AnttiLukats/HackaZynq/THP2015/pre-built/readme.txt

Boot files for Linux boot
use BOOT.BIN to program the SPI flash first, then copy both files to micro SD
