AnttiLukats/HackaZynq/THP2015/pre-built/Propeller/readme.txt

Parallax Propeller 1 Soft implementation, P31, P30 are on FTDI UART

P0..P15 mapped to Arduino digital pins
