AnttiLukats/HackaZynq/THP2015/hw/TE0723/manufacturing reports/PDF/SCH-TE0723-01.PDF

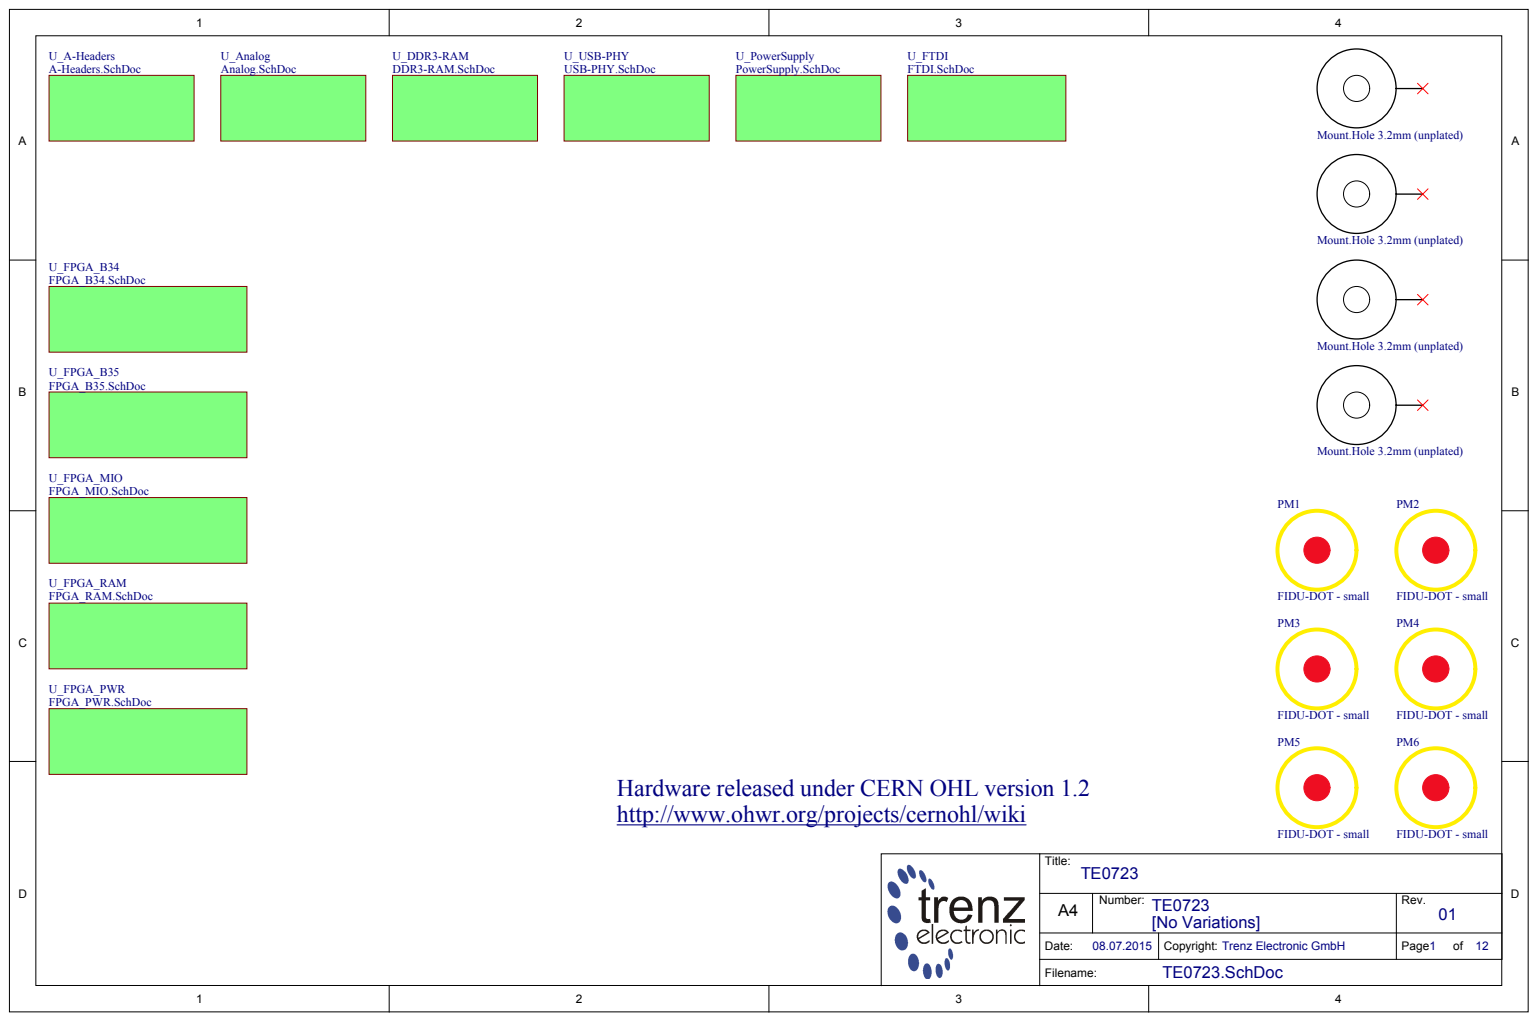
[picture p1: page 1]

Hardware released under CERN OHL version 1.2
http://www.ohwr.org/projects/cernohl/wiki

Title: TE0723

A4 | Number: TE0723 [No Variations] | Rev. 01

Date: 08.07.2015 | Copyright: Trenz Electronic GmbH | Page1 of 12

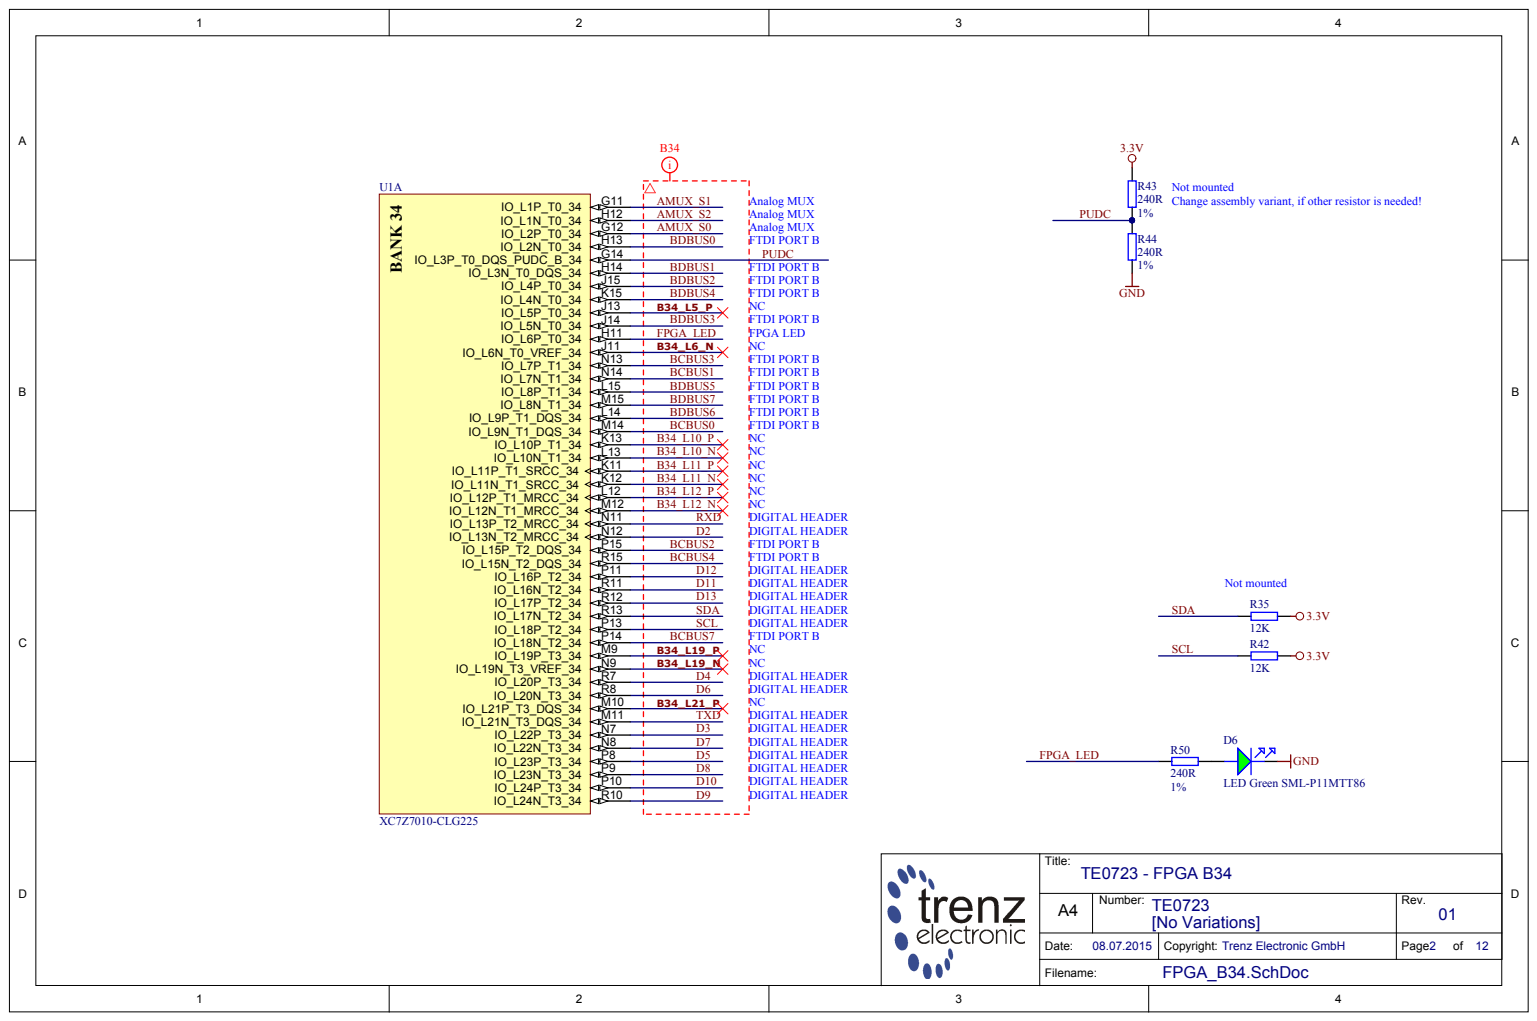
[picture p2: page 2]

Not mounted
Change assembly variant, if other resistor is needed!

Title: TE0723 - FPGA B34

A4 | Number: [No Variations] TE0723 | Rev. 01

Date: 08.07.2015 | Copyright: Trenz Electronic GmbH | Page 2 of 12

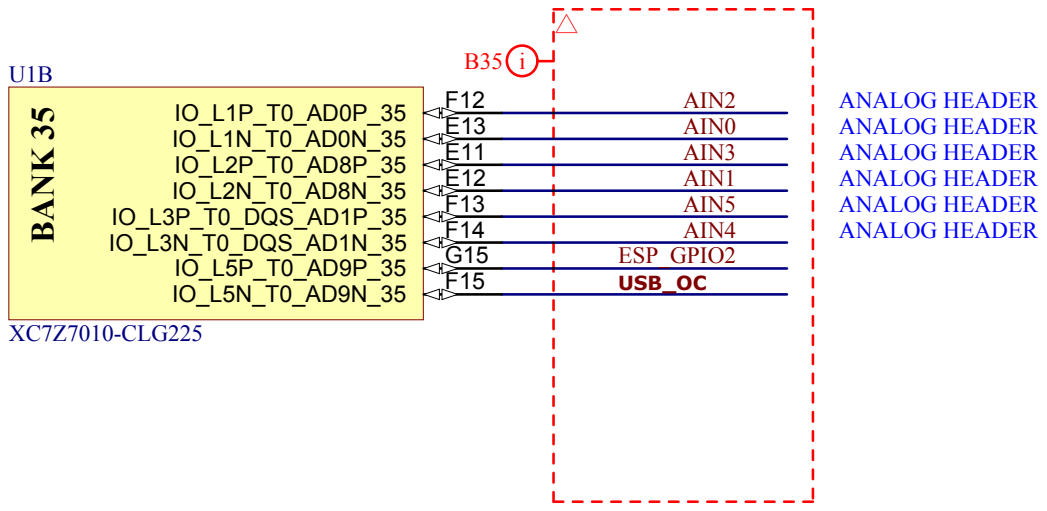
[picture p3: page 3]

Title: TE0723 - FPGA B35

A4 | Number: [No Variations] TE0723 | Rev. 01

Date: 08.07.2015 | Copyright: Trenz Electronic GmbH | Page 3 of 12

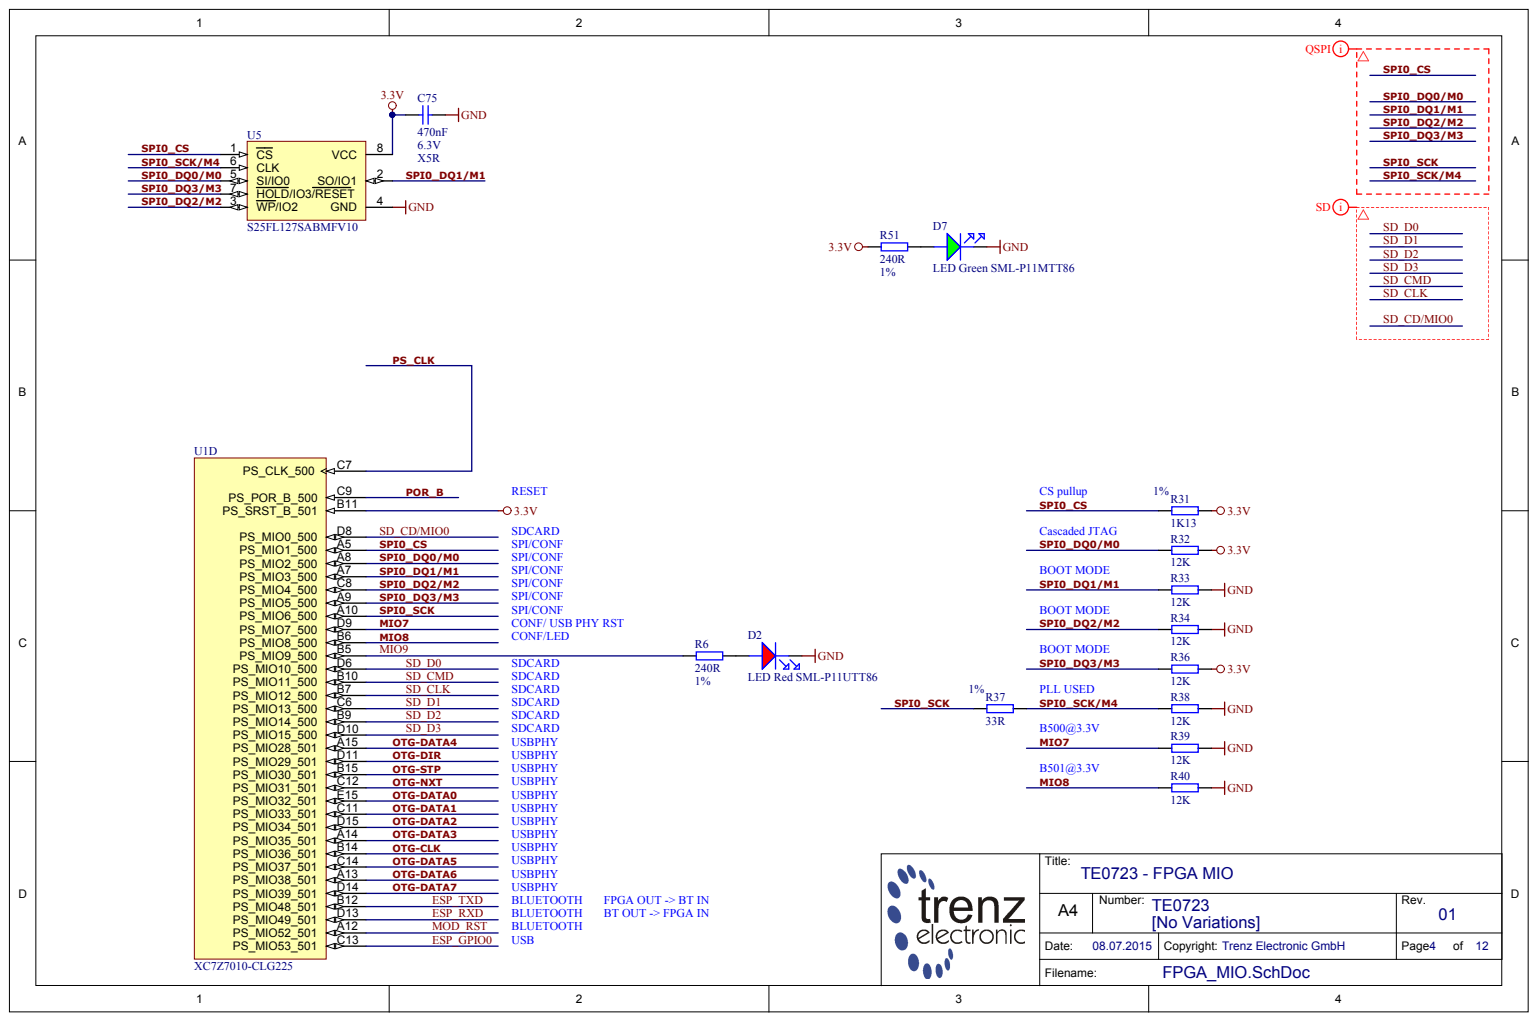
[picture p4: page 4]

Title: TE0723 - FPGA MIO

FPGA OUT -> BT IN
BT OUT -> FPGA IN

A4 | Number: TE0723 [No Variations] | Rev. 01

Date: 08.07.2015 | Copyright: Trenz Electronic GmbH | Page4 of 12

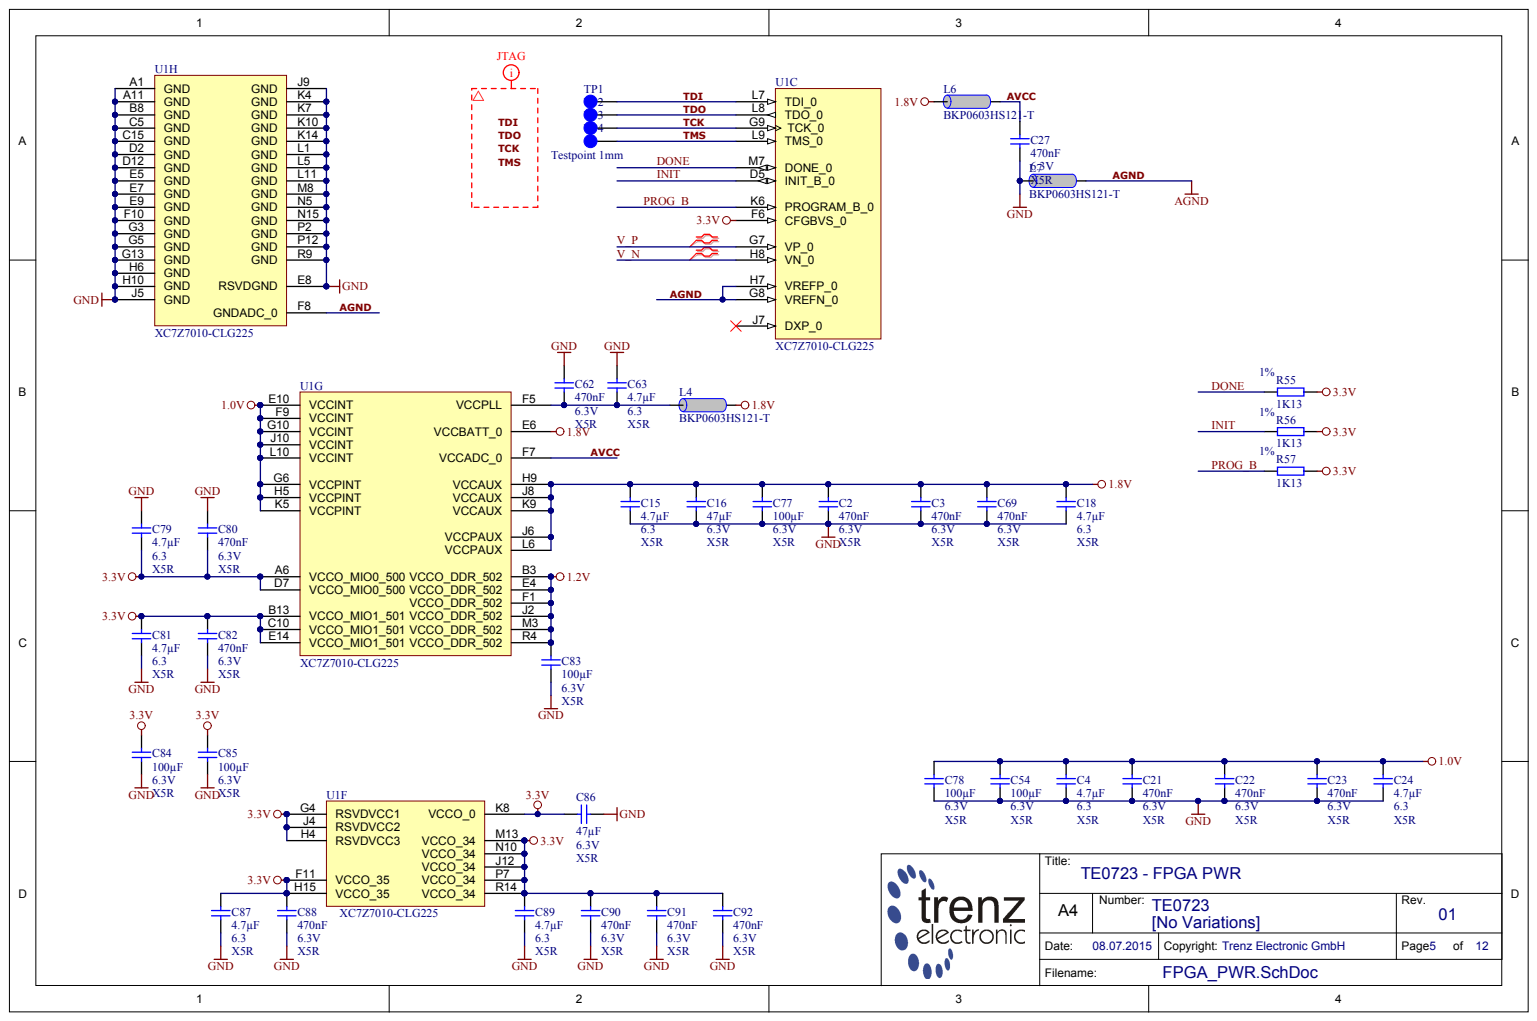
[picture p5: page 5]

A4 | Number: TE0723 [No Variations] | Rev. 01

Date: 08.07.2015 | Copyright: Trenz Electronic GmbH | Page5 of 12

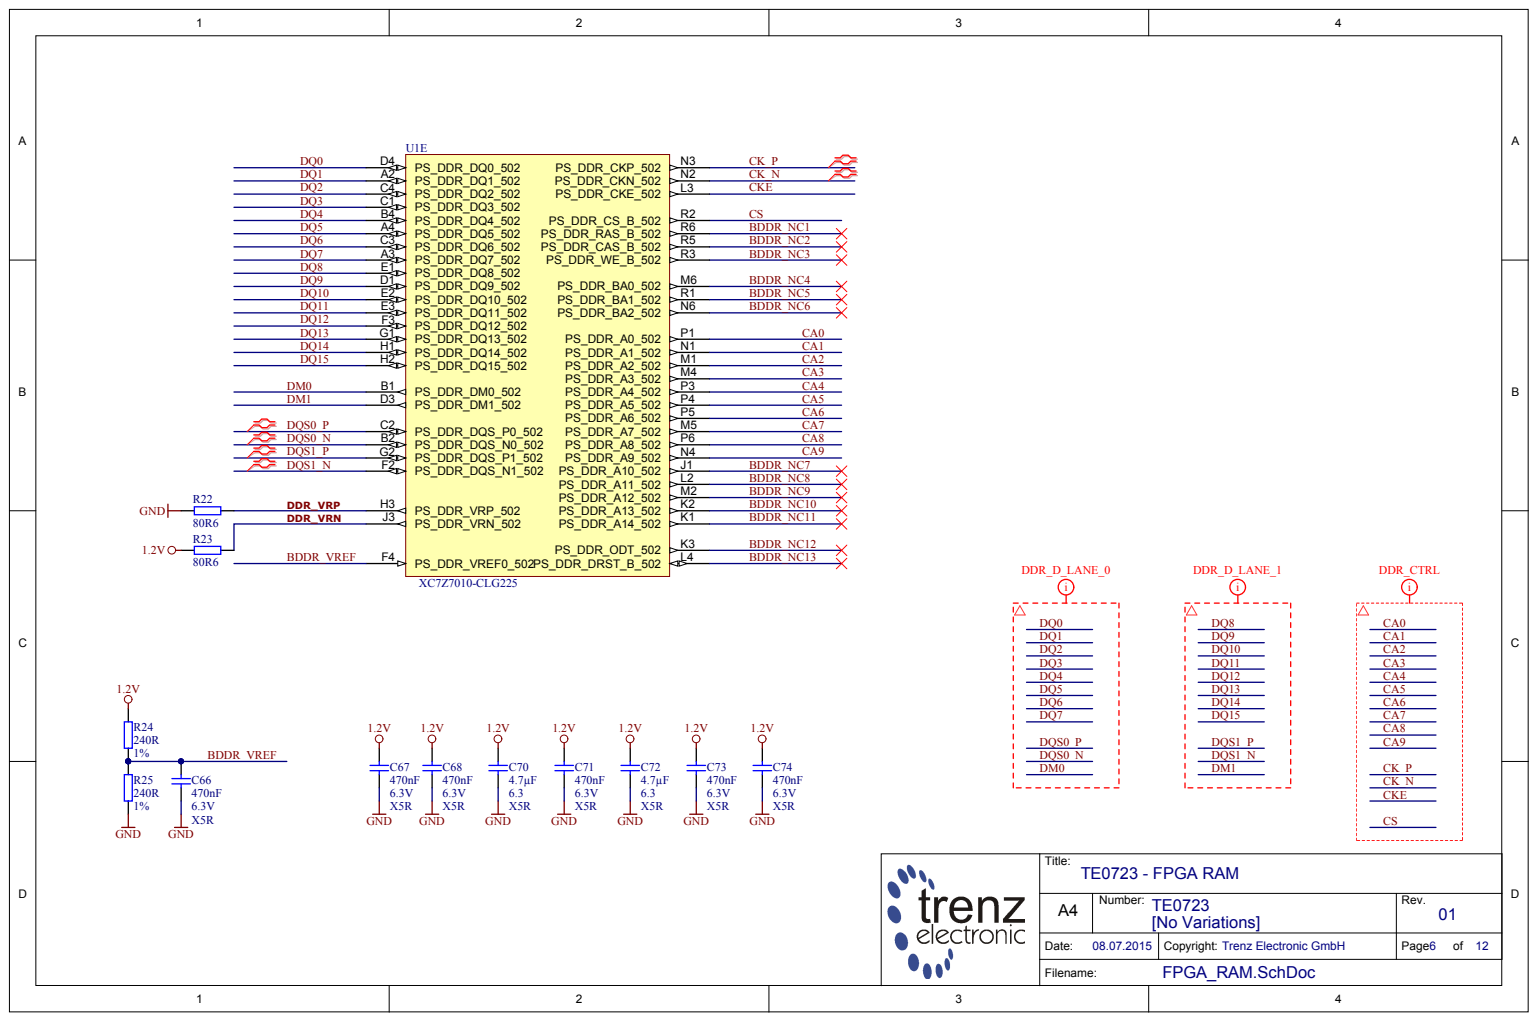
[picture p6: page 6]

Title: TE0723 - FPGA RAM

A4 | Number: TE0723 [No Variations] | Rev. 01

Date: 08.07.2015 | Copyright: Trenz Electronic GmbH | Page6 of 12

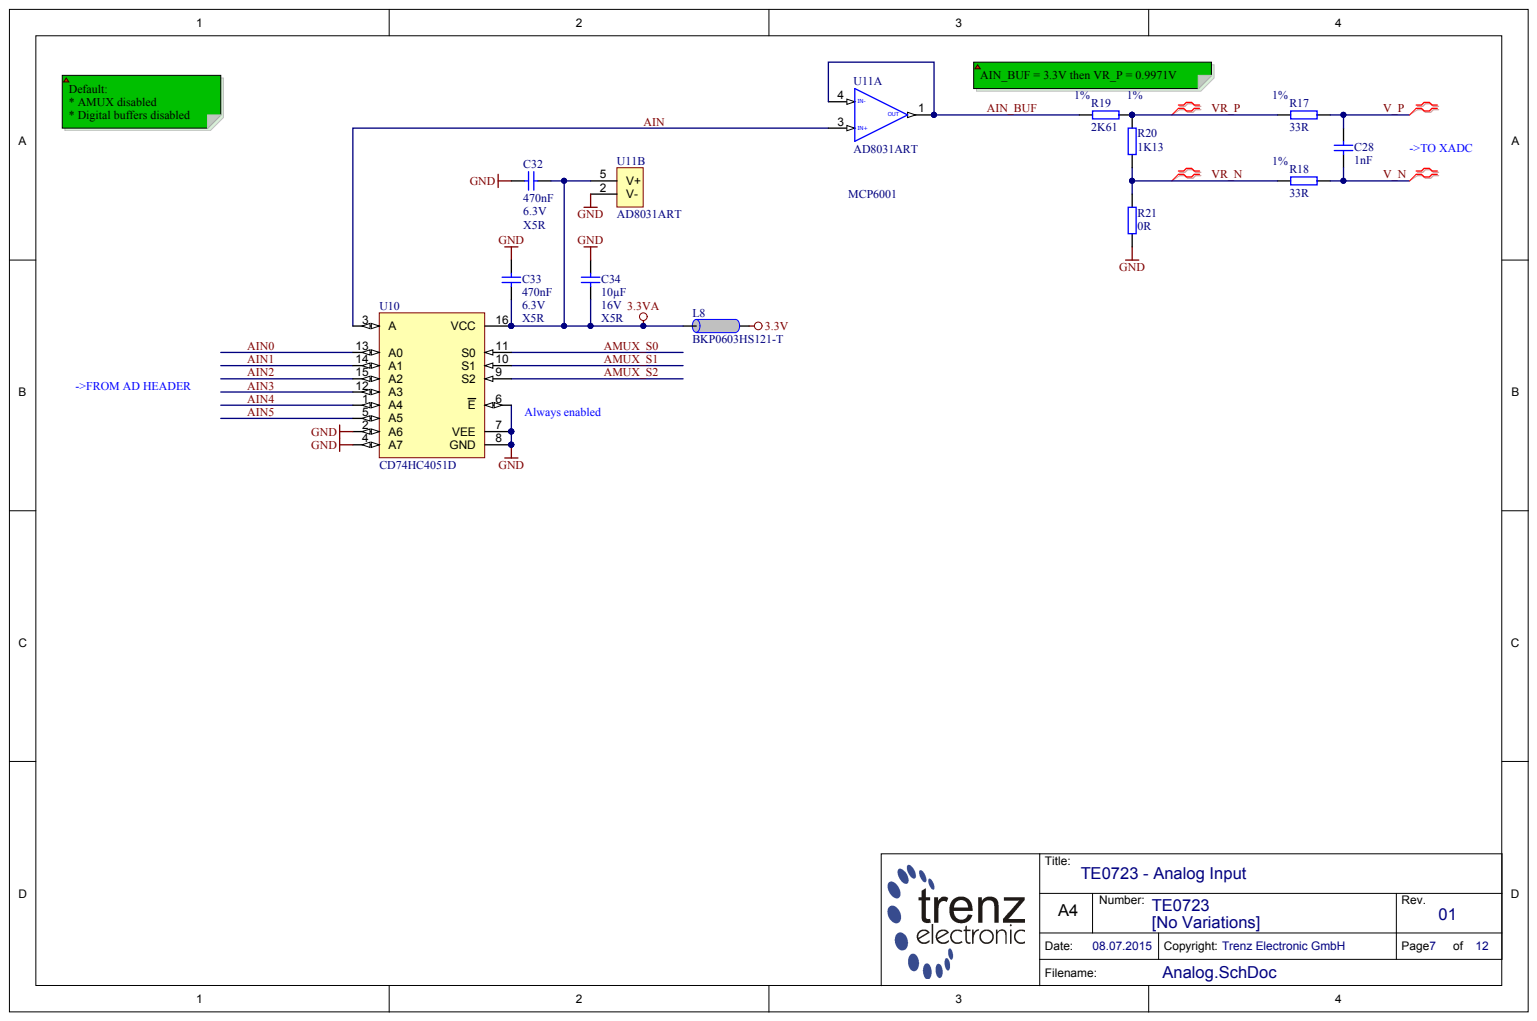
[picture p7: page 7]

Title: TE0723 - Analog Input

A4 | Number: TE0723 [No Variations] | Rev. 01

Date: 08.07.2015 | Copyright: Trenz Electronic GmbH | Page7 of 12

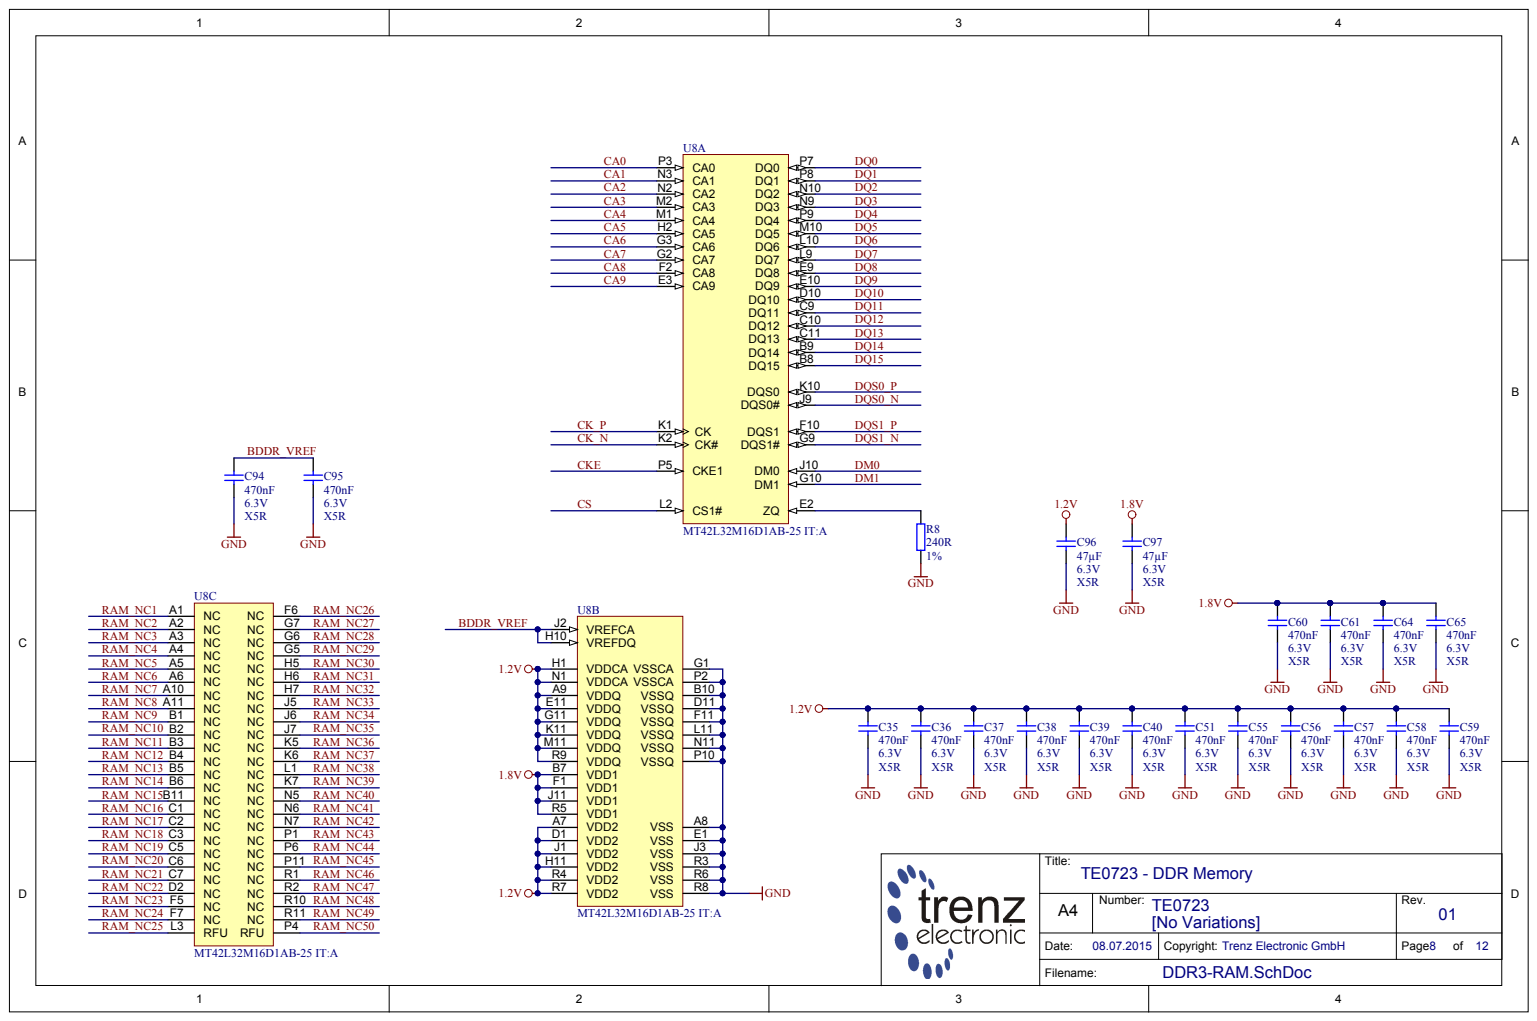
[picture p8: page 8]

A4 | Number: [No Variations] TE0723 | Rev. 01

Date: 08.07.2015 | Copyright: Trenz Electronic GmbH | Page 8 of 12

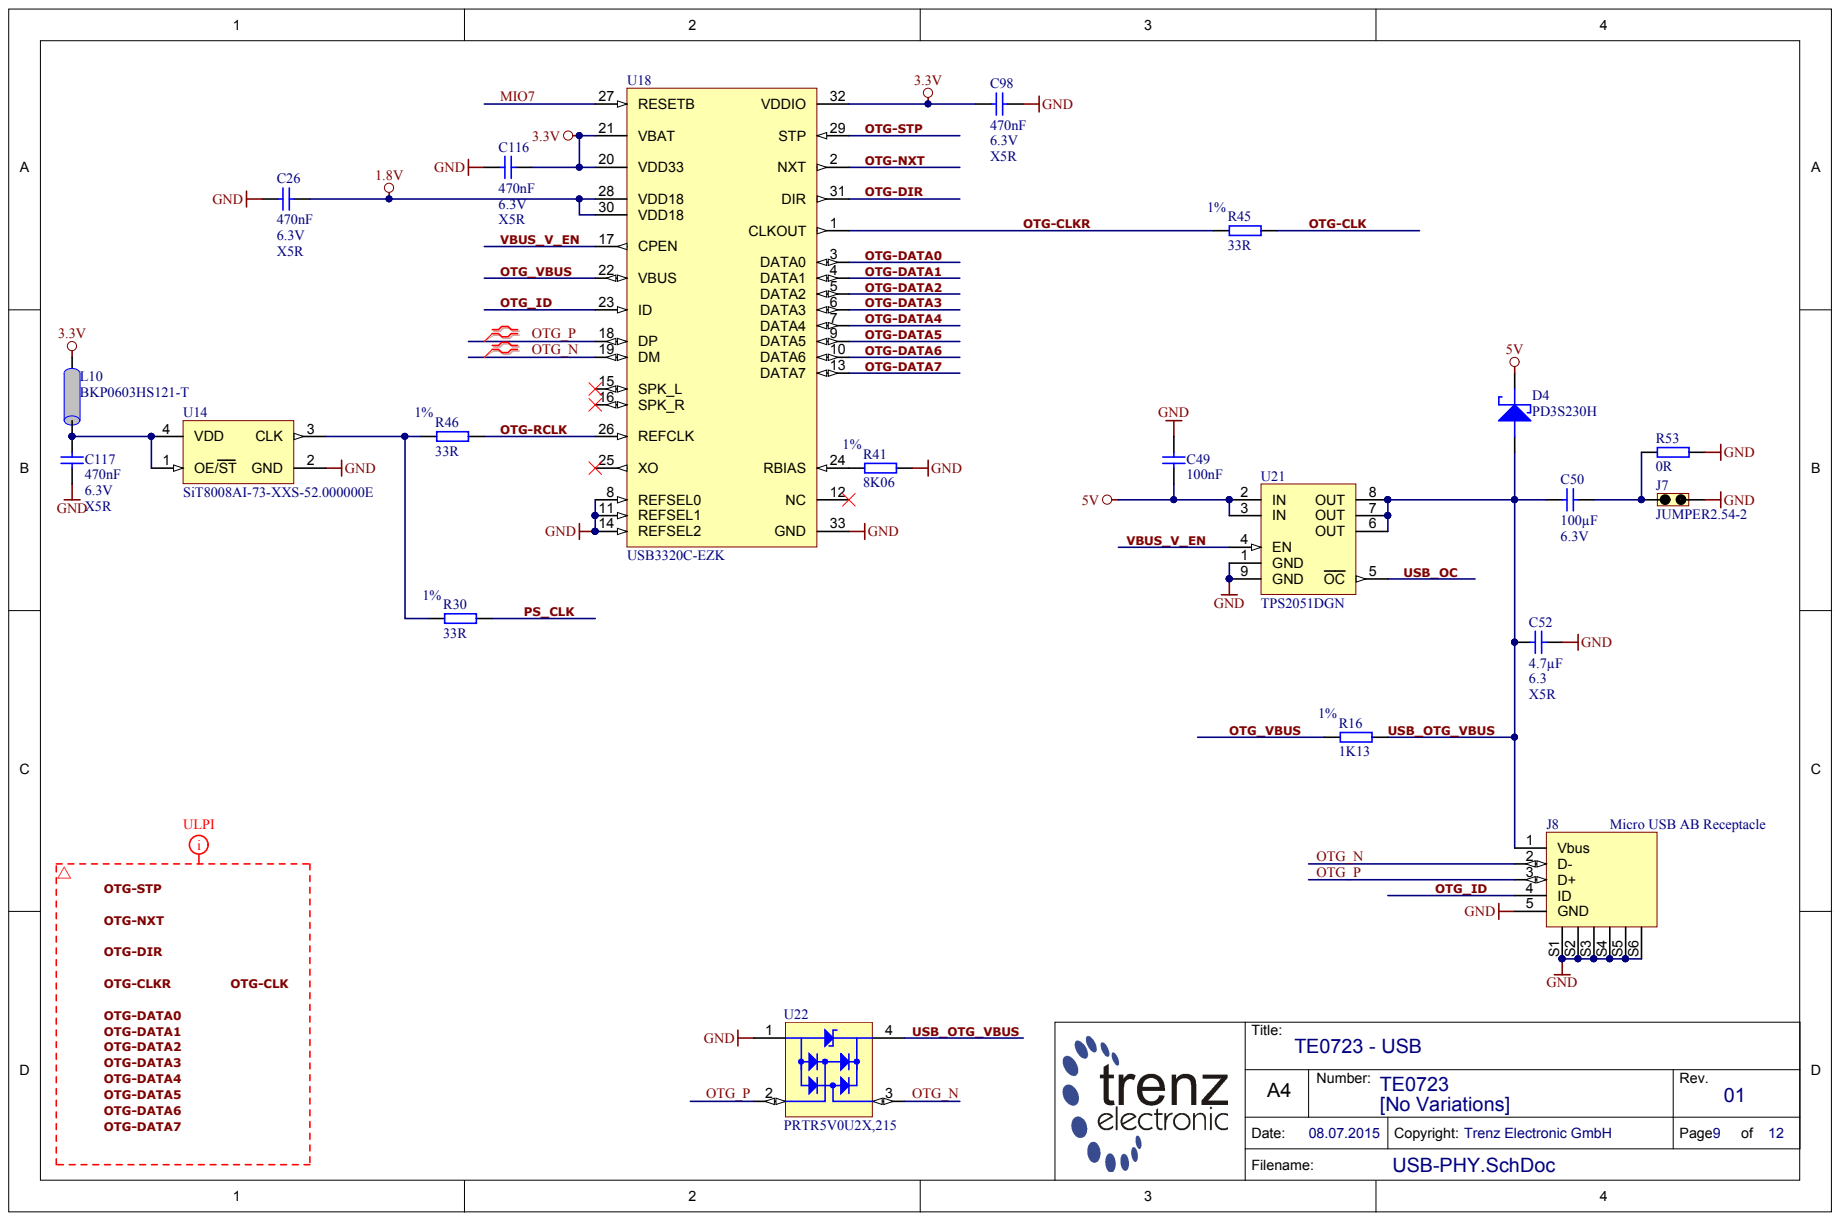
[picture p9: page 9]

Title: TE0723 - USB

A4 | Number: TE0723 [No Variations] | Rev. 01

Date: 08.07.2015 | Copyright: Trenz Electronic GmbH | Page9 of 12

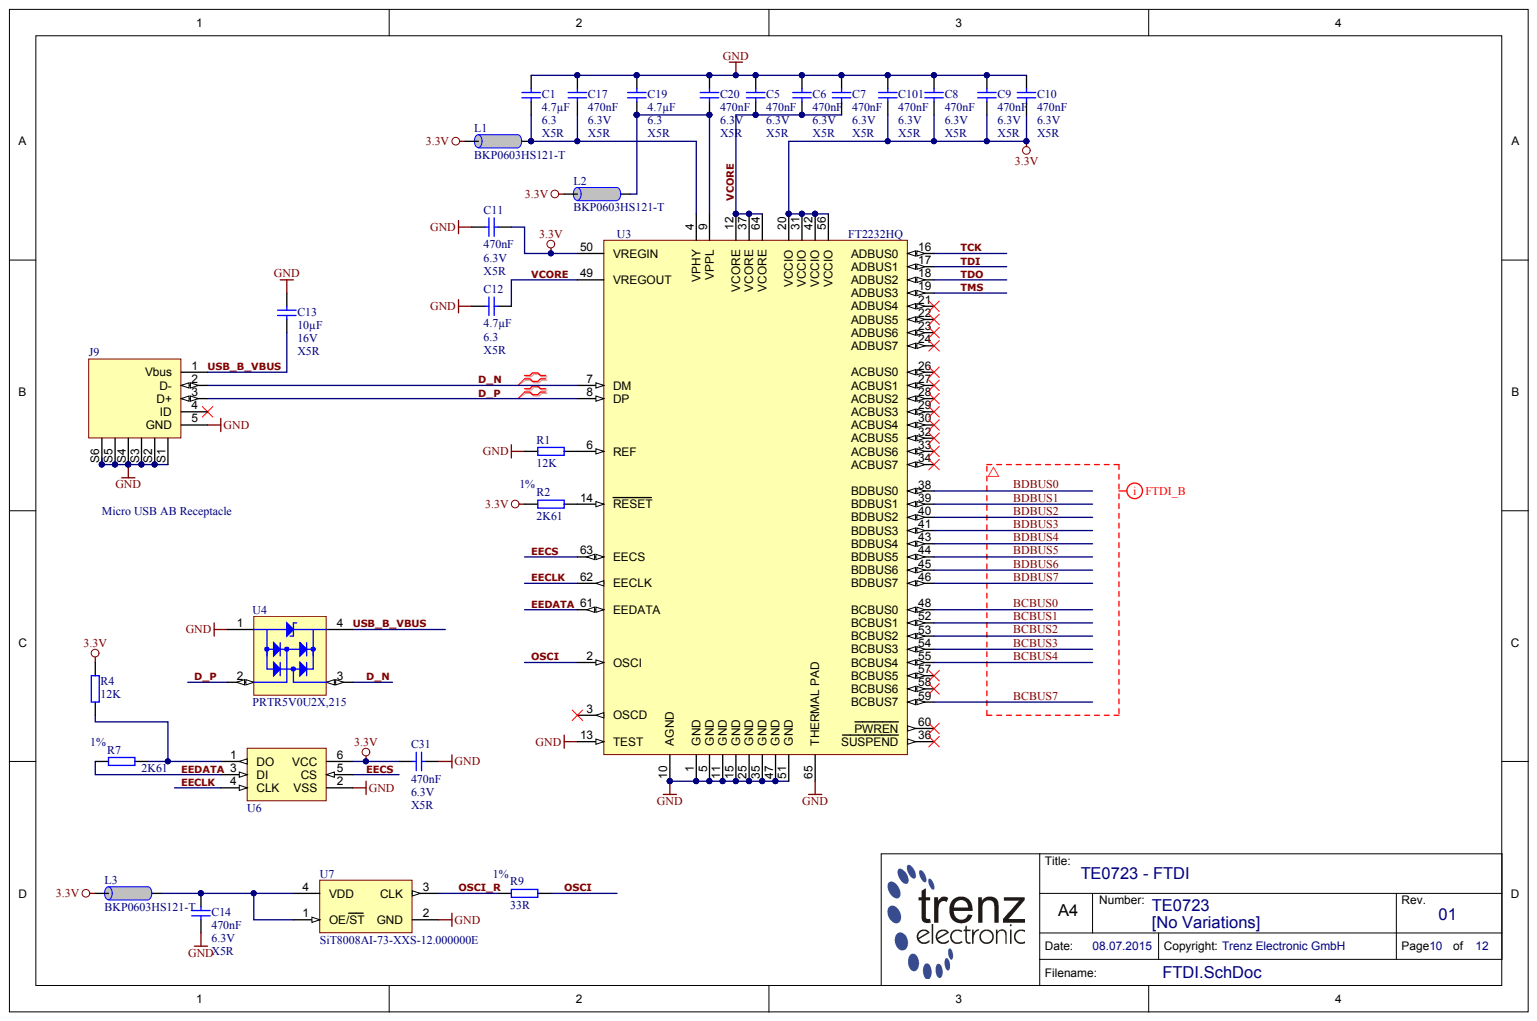
[picture p10: page 10]

REF 6

Micro USB AB Receptacle

EECS 63 EECLK 62 EEDATA 61 OSCI 2 OSCD 3 | BDBUS2

Title: TE0723 - FTDI

A4 | Number: TE0723 [No Variations] | Rev. 01

Date: 08.07.2015 | Copyright: Trenz Electronic GmbH | Page10 of 12

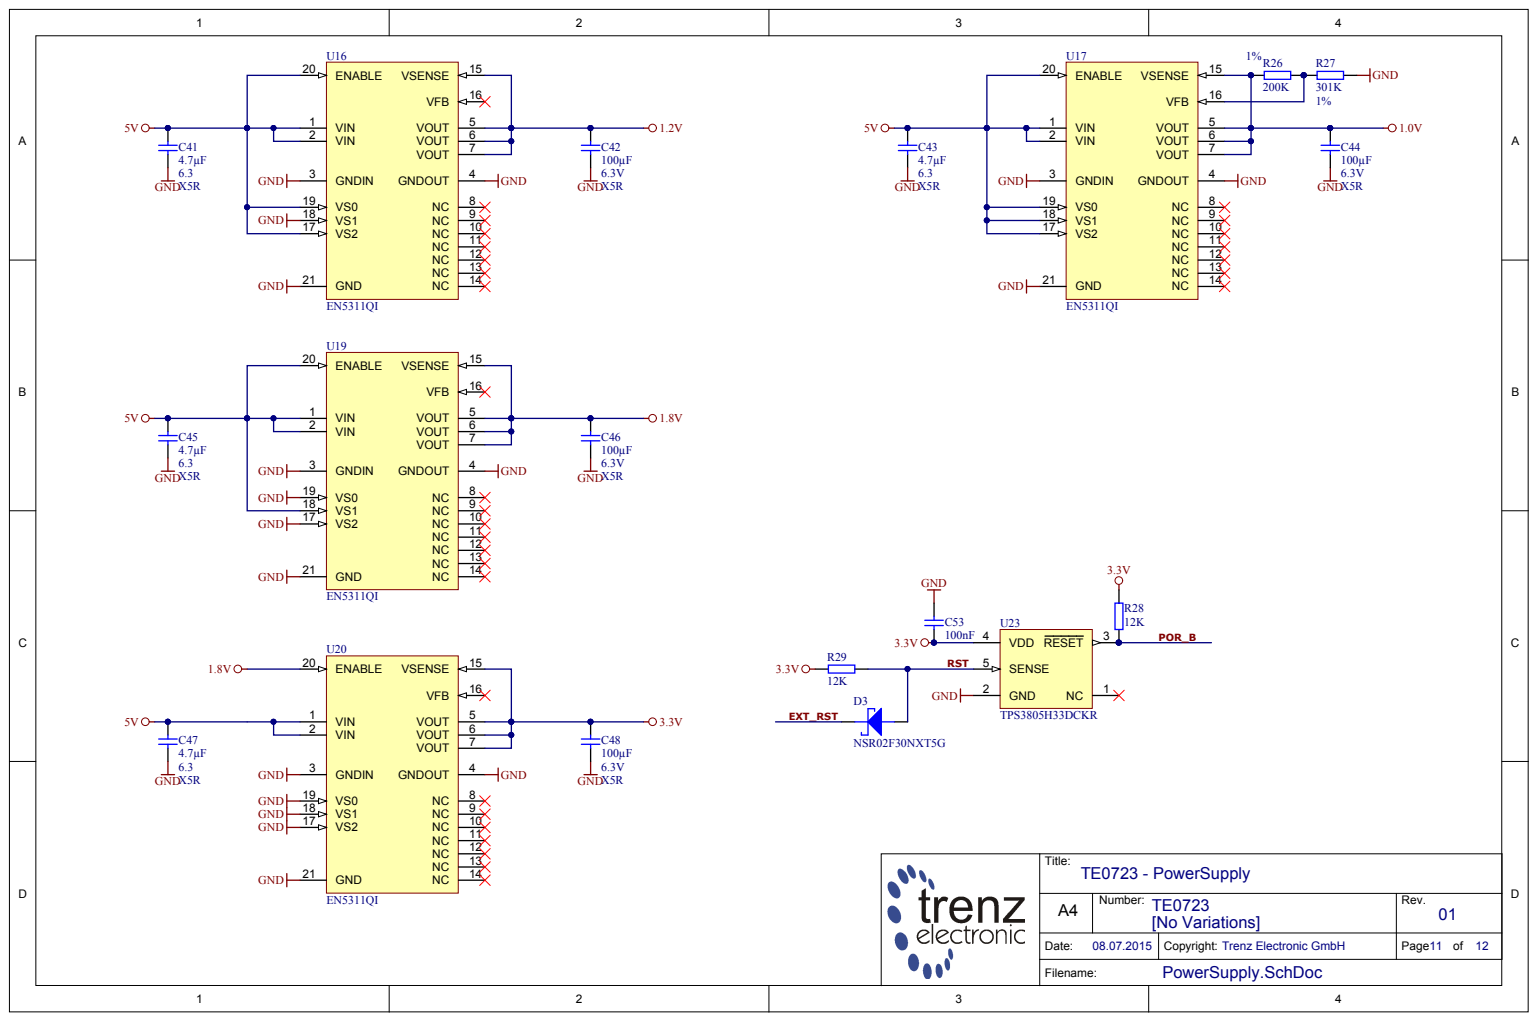
[picture p11: page 11]

A4 | Number: TE0723 [No Variations] | Rev. 01

Date: 08.07.2015 | Copyright: Trenz Electronic GmbH | Page11 of 12

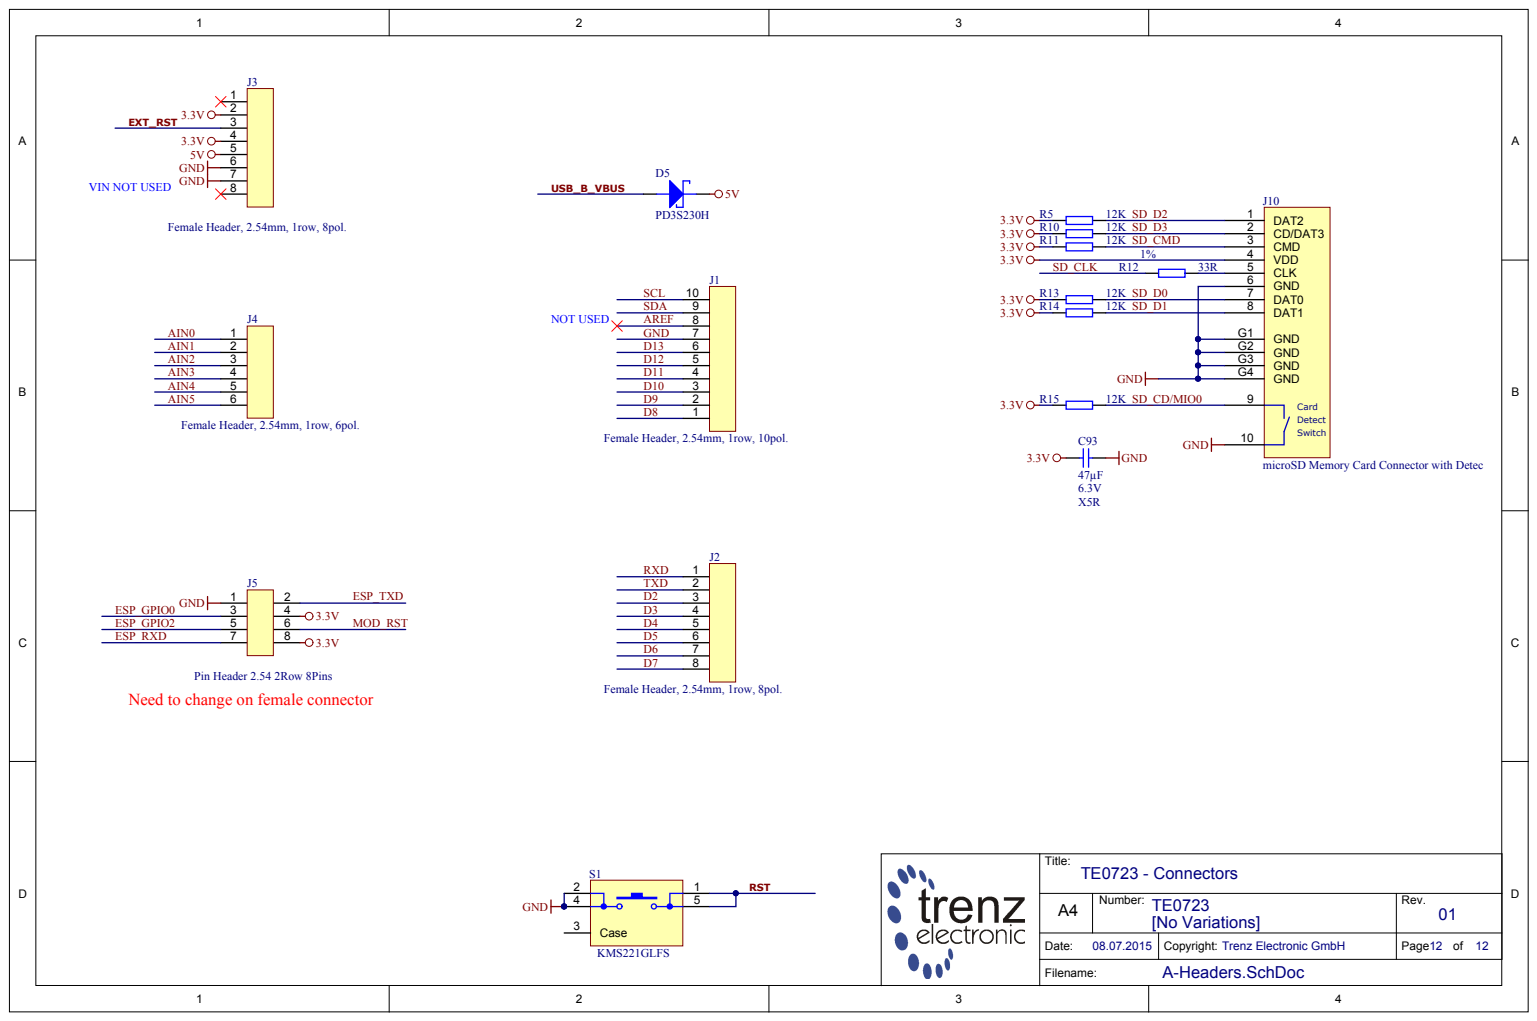
[picture p12: page 12]

DAT0 7
DAT1 8

GND G1
GND G2

microSD Memory Card Connector with Detec

Need to change on female connector

Copyright: Trenz Electronic GmbH
