AnttiLukats/HackaZynq/THP2015/hw/TE0723/manufacturing reports/PDF/3DB-TE0723-01.PDF

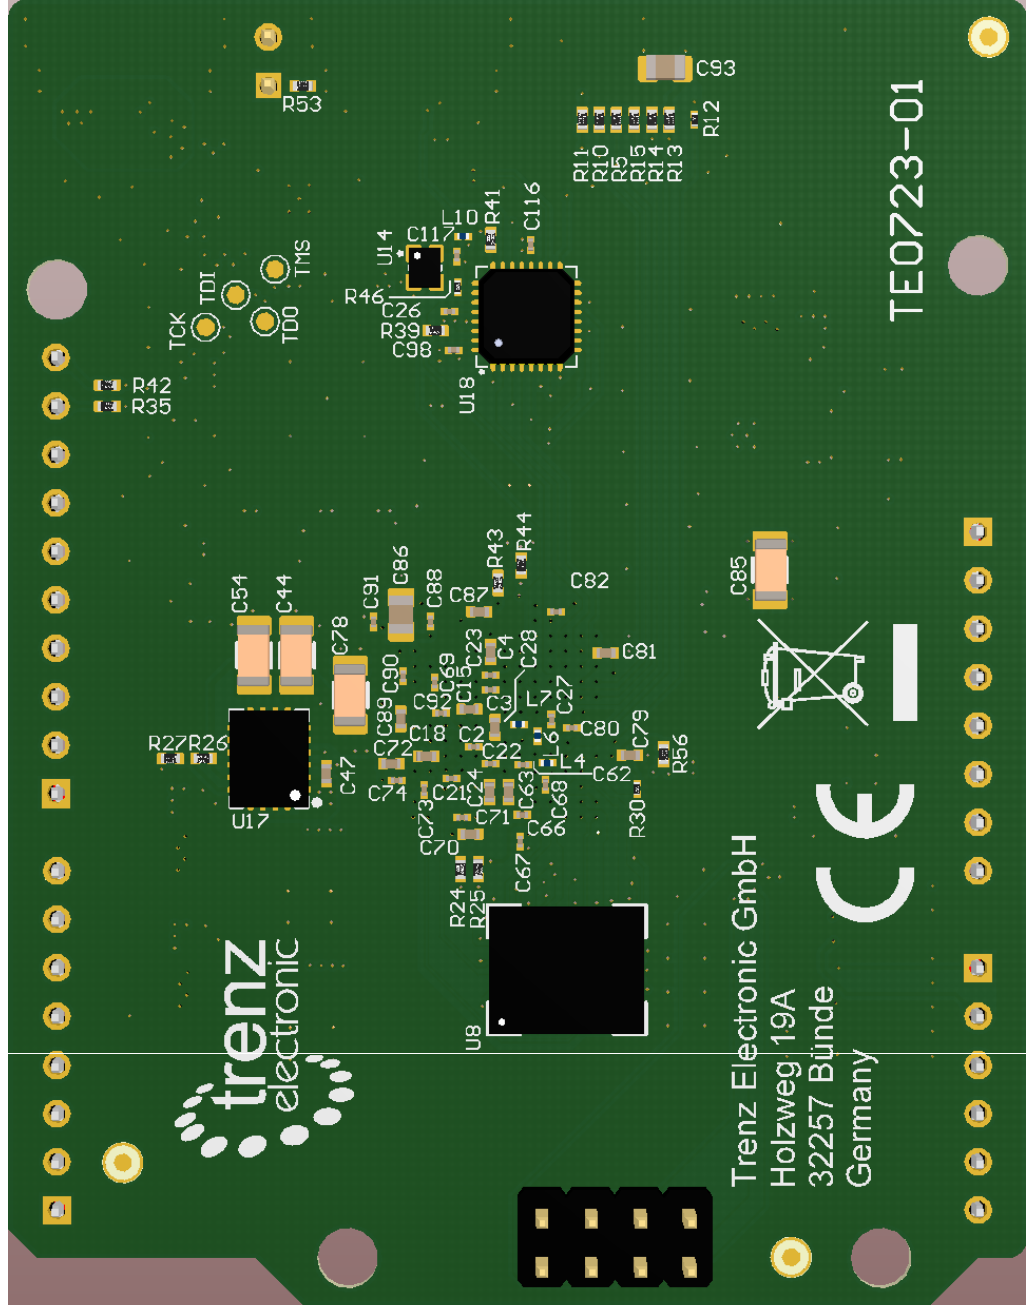
[picture p13: page 1]
