AnttiLukats/HackaZynq/THP2015/hw/TE0723/manufacturing reports/PDF/3DT-TE0723-01.PDF

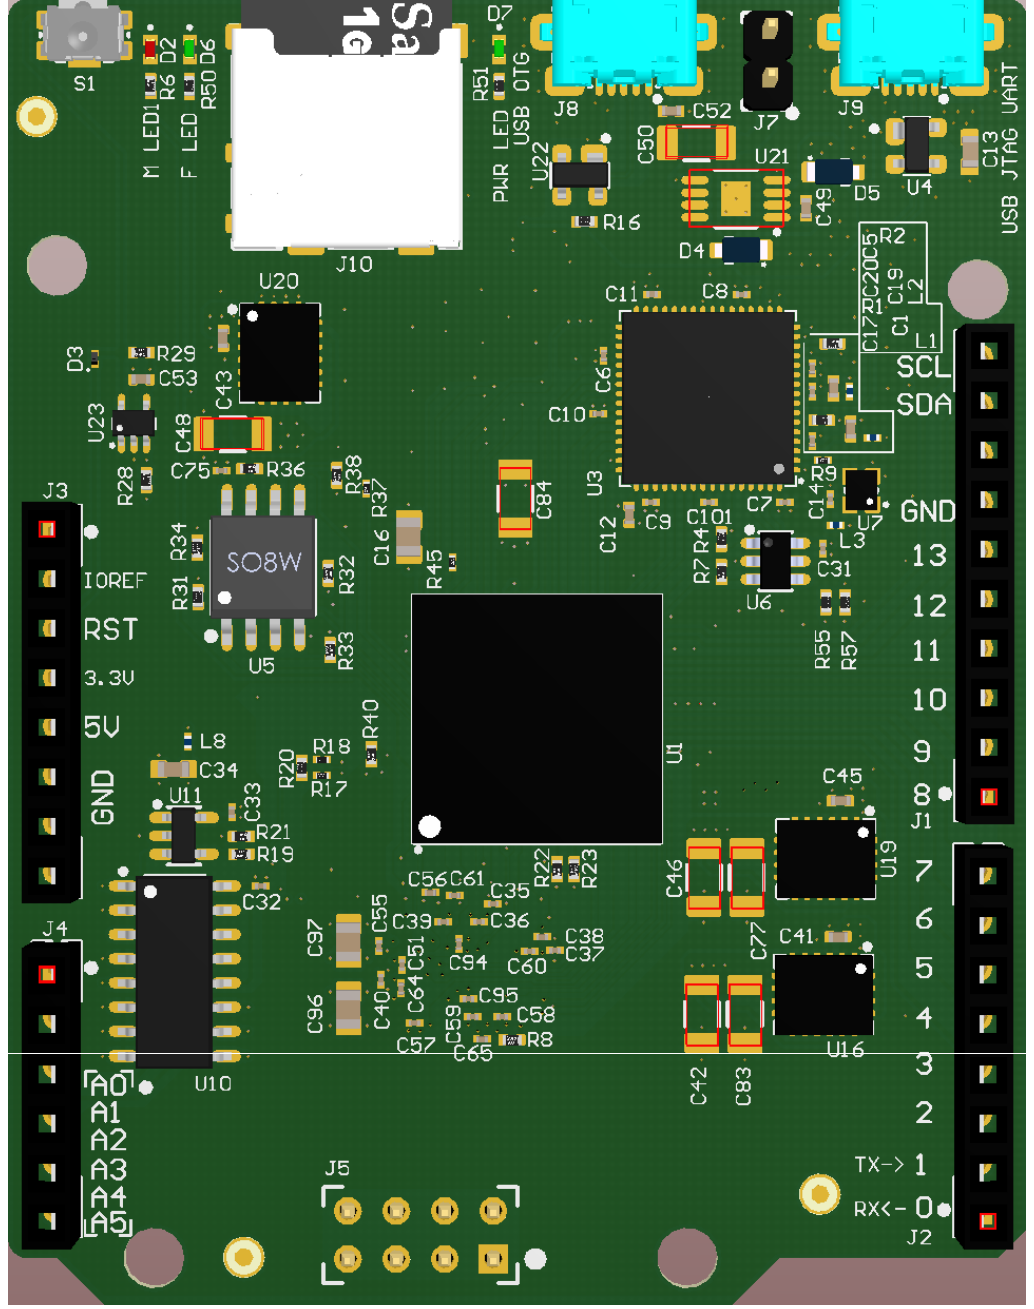
[picture p14: page 1]
