AnttiLukats/HackaZynq/THP2015/hw/TE0723/manufacturing reports/PDF/AD-TE0723-01.PDF

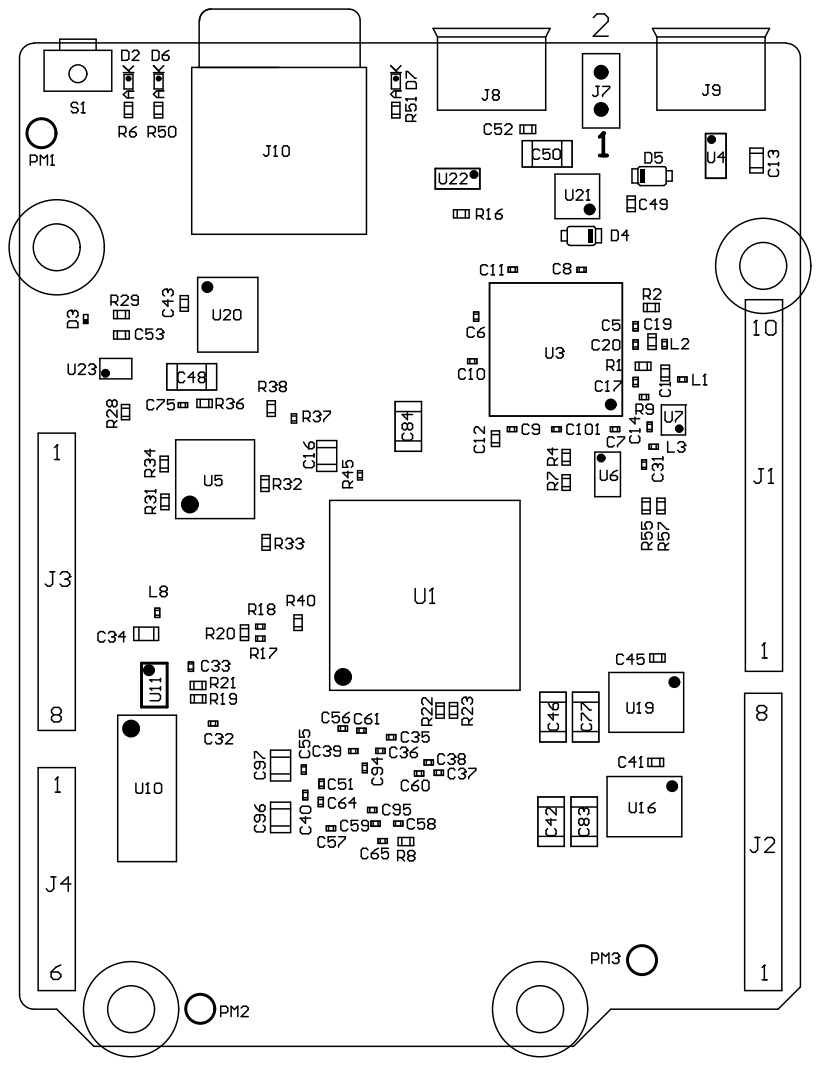
[picture p15: page 1]

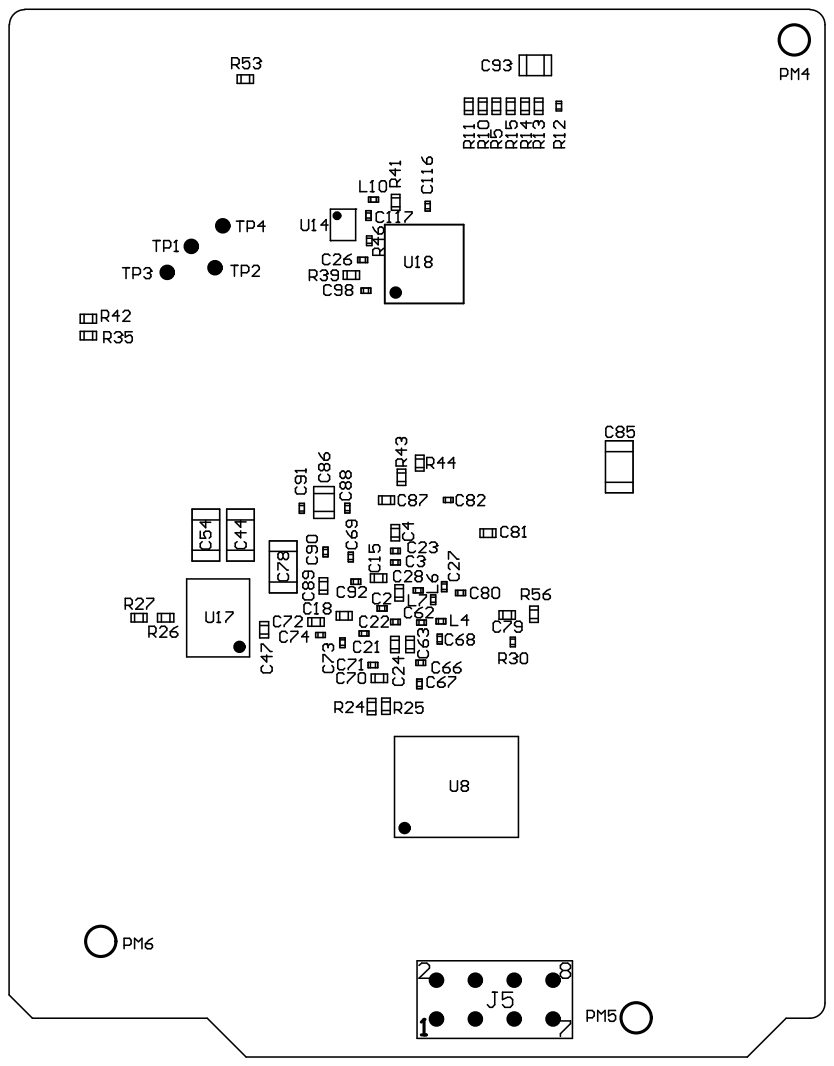
[picture p16: page 2]

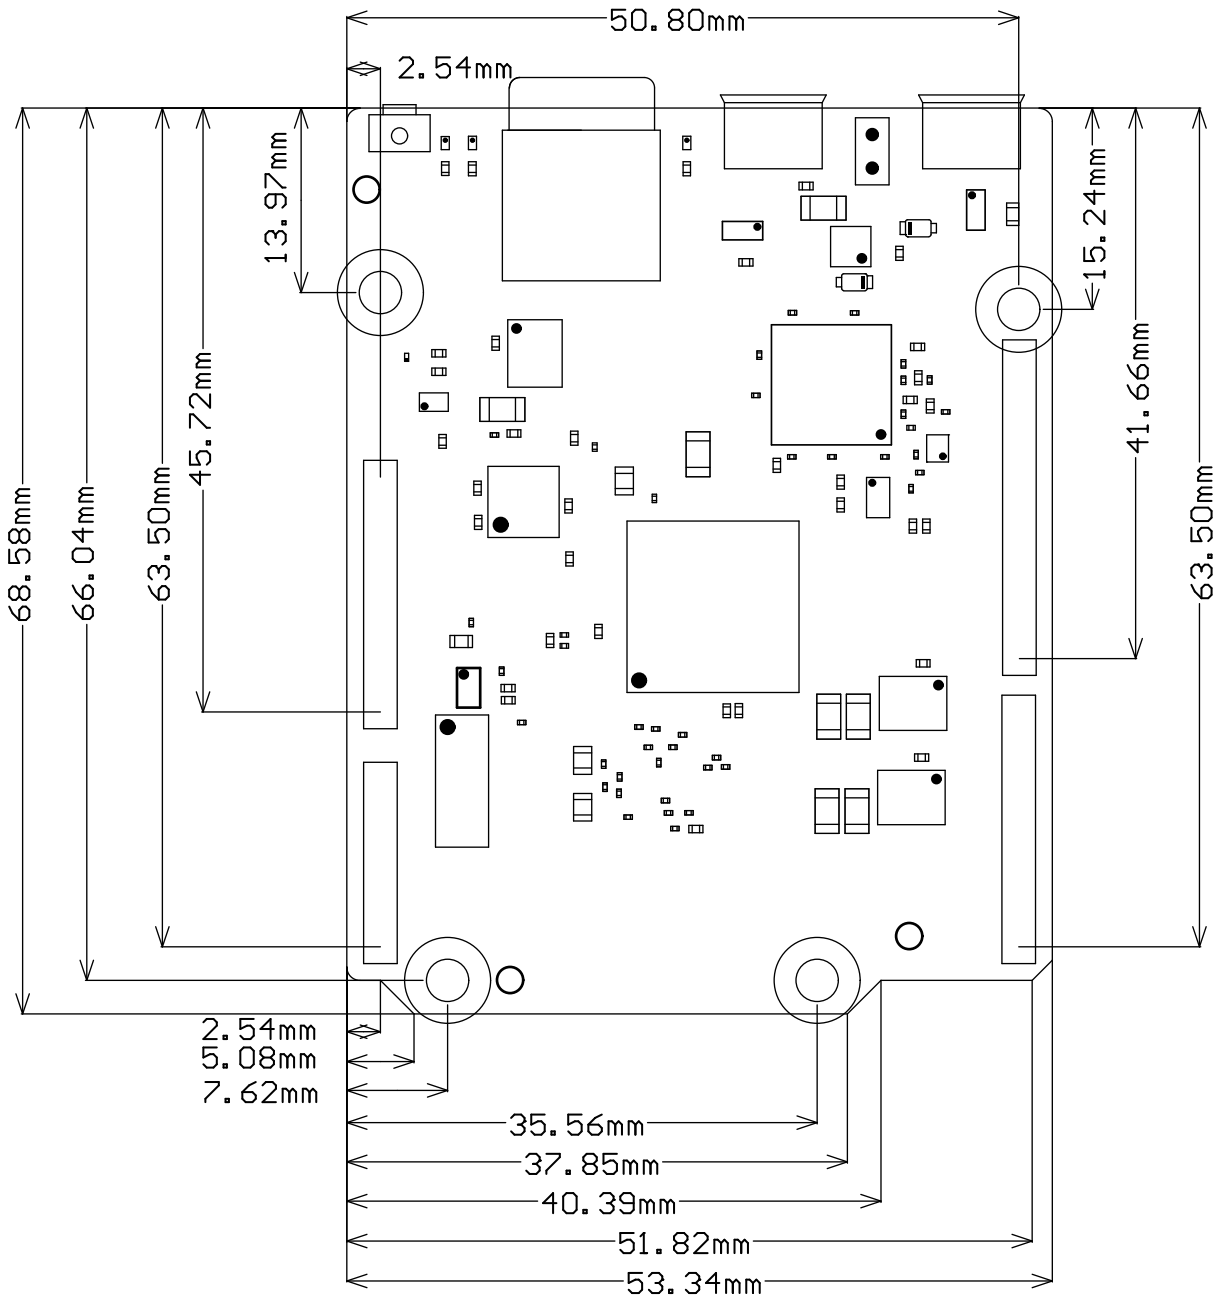
[picture p17: page 3]

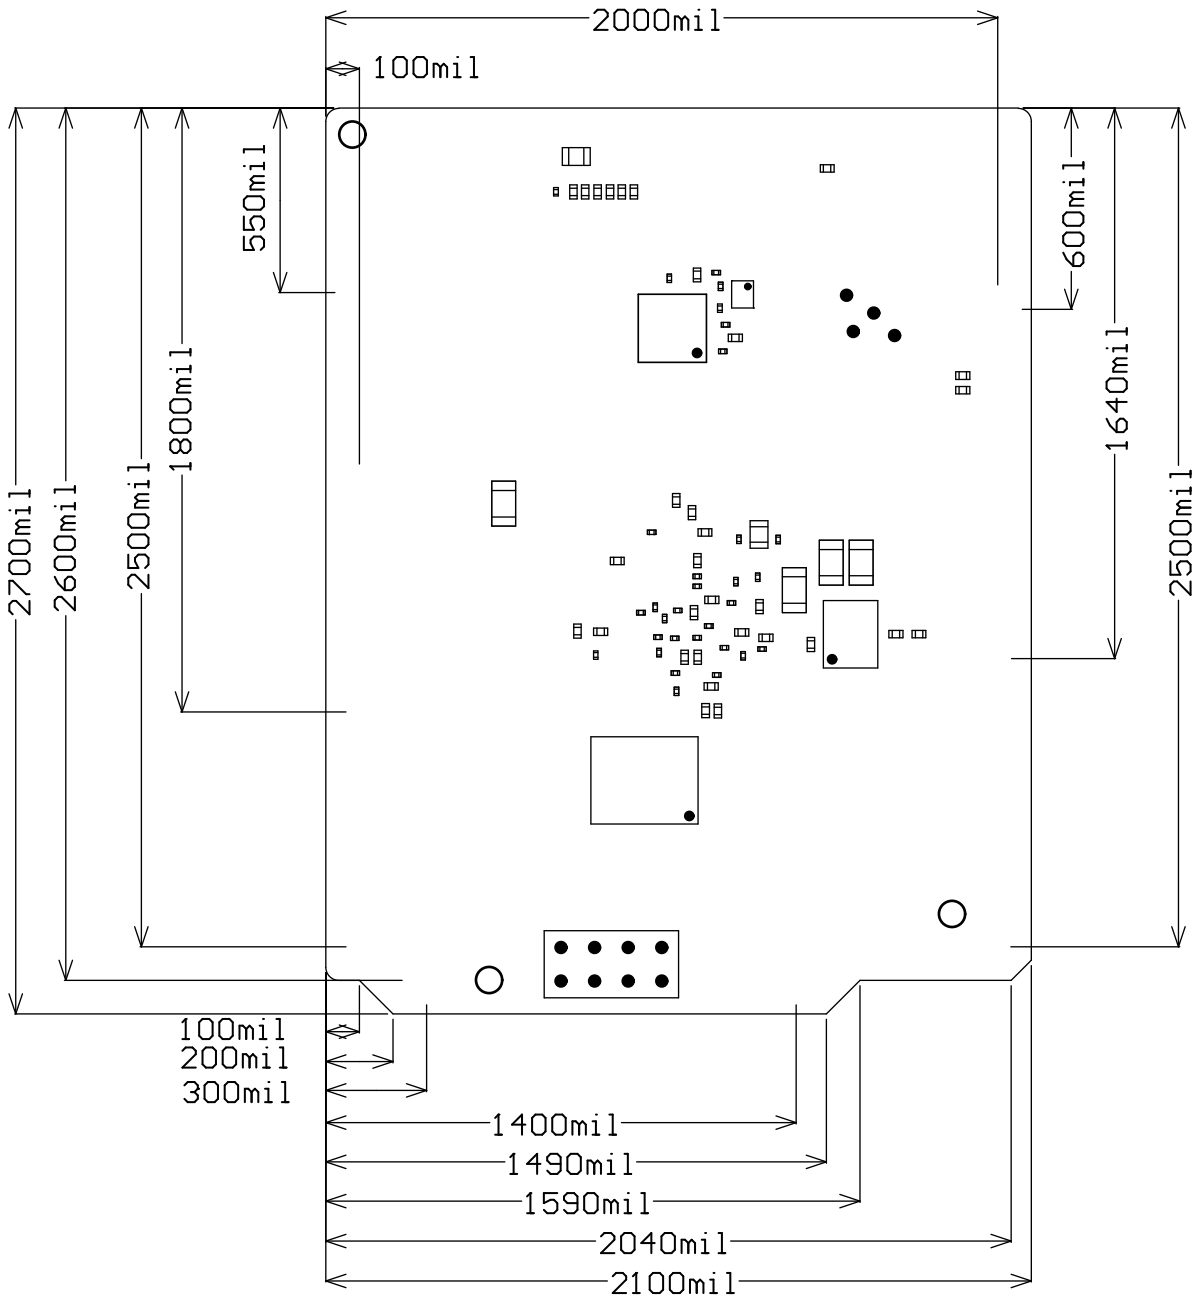
[picture p18: page 4]
