AnttiLukats/HackaZynq/(list of files, drawings)

Other design files:
THP2015/hw/TE0723/A-Headers.SchDoc
THP2015/hw/TE0723/Analog.SchDoc
THP2015/hw/TE0723/DDR3-RAM.SchDoc
THP2015/hw/TE0723/FPGA_B34.SchDoc
THP2015/hw/TE0723/FPGA_B35.SchDoc
THP2015/hw/TE0723/FPGA_MIO.SchDoc
THP2015/hw/TE0723/FPGA_PWR.SchDoc
THP2015/hw/TE0723/FPGA_RAM.SchDoc
THP2015/hw/TE0723/FTDI.SchDoc
THP2015/hw/TE0723/PowerSupply.SchDoc
THP2015/hw/TE0723/TE0723.PrjPCB
THP2015/hw/TE0723/TE0723.SchDoc
THP2015/hw/TE0723/USB-PHY.SchDoc
