AnttiLukats/HackaZynq/(commit log)

2015-08-17 CAD file commit
    [A-Headers.SchDoc, Analog.SchDoc, BOM-TE0723-01.csv, DDR3-RAM.SchDoc, FPGA_B34.SchDoc, FPGA_B35.SchDoc, FPGA_MIO.SchDoc, FPGA_PWR.SchDoc]
2015-08-19 added propeller binaries
